jmiv-afk/IV-Curve-Gen/IV_shield_layout.JPG

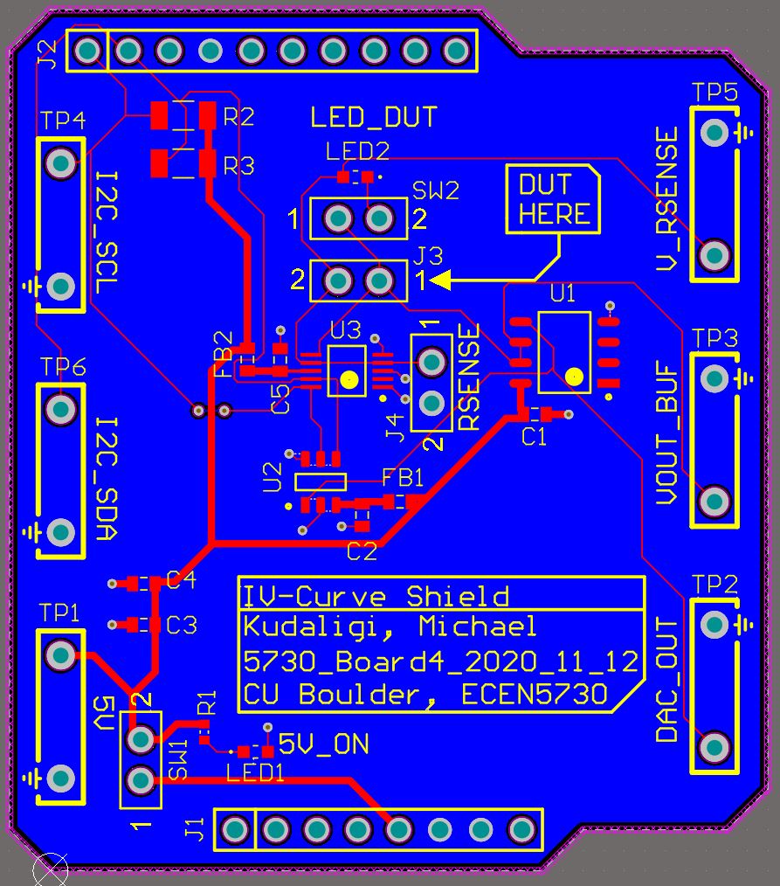
IV_shield_layout.JPG
