jmiv-afk/IV-Curve-Gen/(commit log)

2020-11-12 add sample plot
2020-11-12 Add schematic and layout
